nseidle/WOW-Scanner/README.md

Grocery Scanner
=======

Grocery scanner is an interactive exhibit at the [WOW kid's museum](http://www.wowchildrensmuseum.org/) in Lafayette, CO. Sliding a plastic fruit, empty box, or even your hand causes the scanner to turn on a bright red LED and beep with that satisfying grocery store checkout beep.

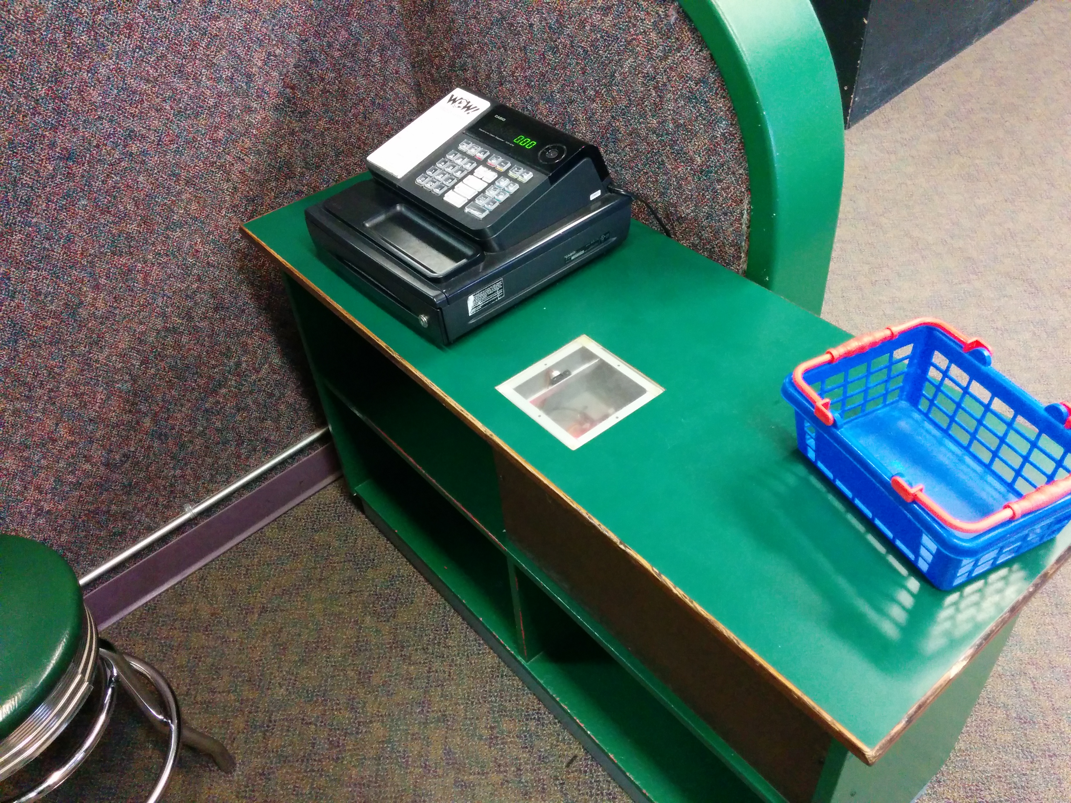
[picture p1: images/Scanner-Low-Height-Checkout.jpg]
The scanner installed in low height checkout counter


This exhibit was created by Chris Francis and has been maintained by Nathan Seidle. It is a tremendously popular exhibit. Kids really enjoy being able to do what their parents do at the store.

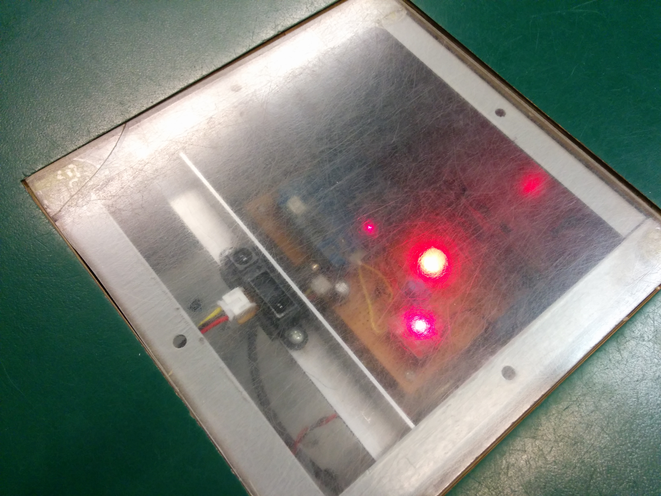
[picture p2: images/Scanner.jpg]
Scanner installed
  

The scanner is flush mounted to a low height checkout counter for small kids. The electronics are placed in a metal box with a clear acrylic cover. The cover in this picture has had 4 years of significant wear and tear but the IR distance sensor continues to function without problems.

This exhibit is rock solid and had been running for multiple years without maintenance.

License Information
-------------------

The hardware design and firmware are released under [Creative Commons Share-alike 3.0](http://creativecommons.org/licenses/by-sa/3.0/).  

Feel free to create your own copy of the Grocery Scanner. All I ask is that you include attribution of 'Based on the Grocery Scanner by Chris Francis'.

Repository Contents
-------------------
* **/hardware** - Unproven Eagle PCB layouts for an Arduino shield 
* **/firmware** - The sketch that runs on the Arduino Pro 
* **/images** - Images and a video of the scanner in use
