nseidle/WOW-Scanner/hardware/remote board.brd

## EAGLE design hardware/remote board.brd (2013-04-22)

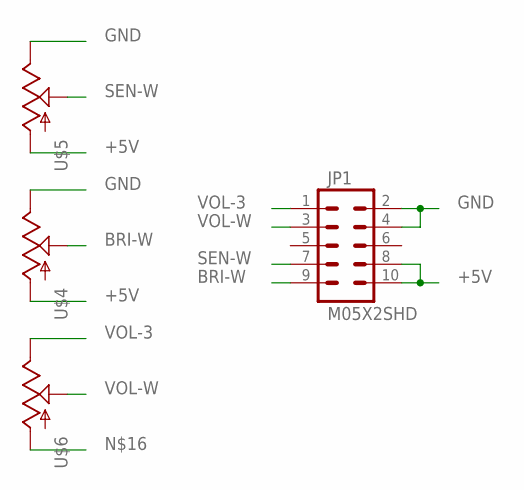
[picture p3: schematic remote board.sch]

Parts:
JP1: M05X2SHD; 2X5-SHROUDED
U$4, U$5, U$6: POT100K_3362U; 3362U

Connections:
+5V: JP1.8, JP1.10, U$4.P$3 (A), U$5.P$3 (A)
BRI-W: JP1.9, U$4.P$2 (S)
GND: JP1.2, JP1.4, U$4.P$1 (E), U$5.P$1 (E)
SEN-W: JP1.7, U$5.P$2 (S)
VOL-3: JP1.1, U$6.P$1 (E)
VOL-W: JP1.3, U$6.P$2 (S)

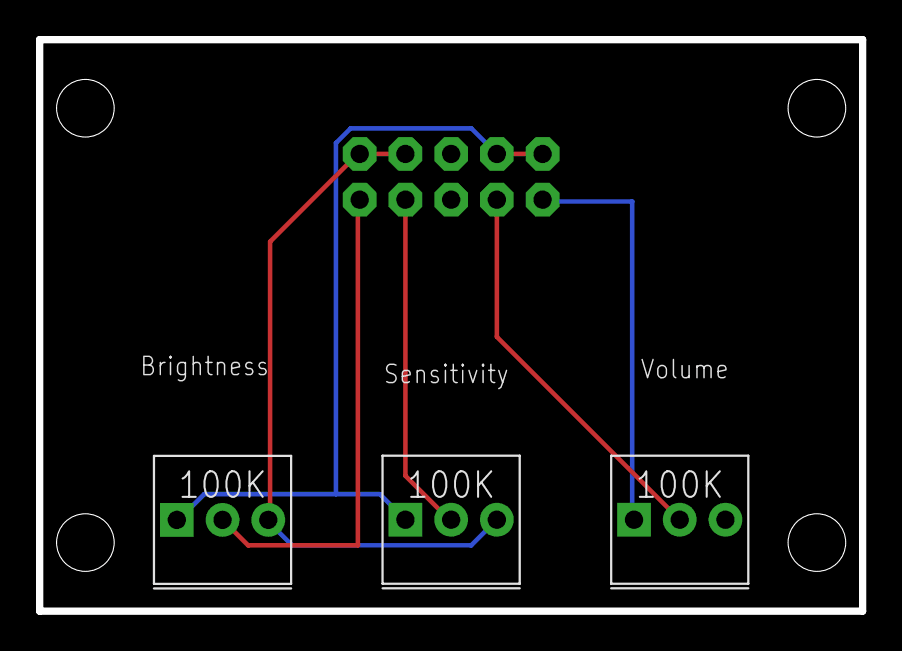
[picture p4: board remote board.brd from above]

Board: 2 copper layers, 45.7 x 31.8 mm, 4 parts (1 on the bottom side), 6 nets.
