nseidle/WOW-Scanner/hardware/WOW Scanner.brd

## EAGLE design hardware/WOW Scanner.brd (2013-04-22)

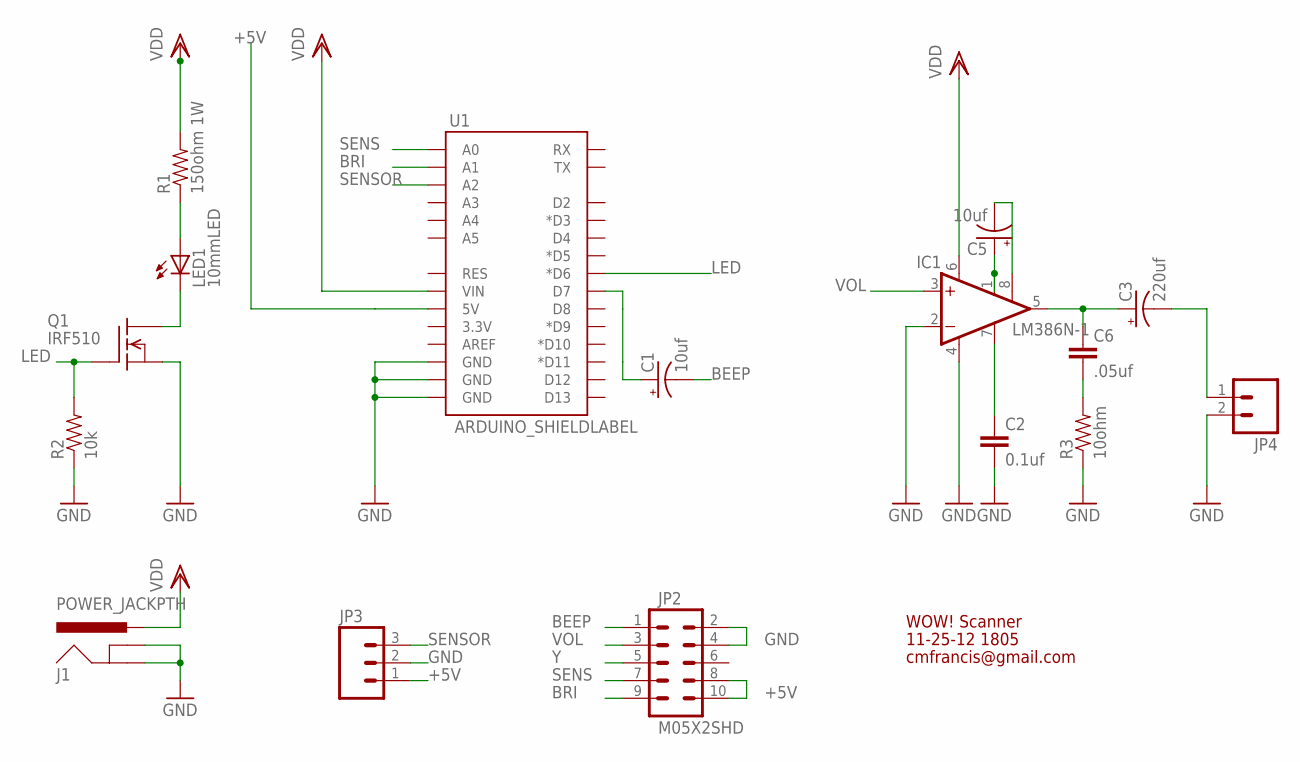
[picture p5: schematic WOW Scanner.sch]

Parts:
C1, C5: 10uf; CPOL-RADIAL-10UF-25V
C2: 0.1uf; CAP-PTH-SMALL
C3: 220uf; CPOL-RADIAL-100UF-25V
C6: .05uf; CAP-PTH-SMALL
IC1: LM386N-1; DIL08
J1: POWER_JACKPTH; POWER_JACK_PTH
JP2: M05X2SHD; 2X5-SHROUDED
JP3: M03JST-PTH; JST-3-PTH
JP4: M02PTH; 1X02
LED1: 10mmLED; LED10MM
Q1: IRF510; TO220
R1: 150ohm 1W; AXIAL-0.6
R2: 10k; AXIAL-0.4
R3: 10ohm; AXIAL-0.4
U1: ARDUINO_SHIELDLABEL; DUEMILANOVE_SHIELD

Connections:
+5V: JP2.8, JP2.10, JP3.1, U1.5V
BEEP: C1.2 (-), JP2.1
BRI: JP2.9, U1.A1
GND: C2.2, IC1.2 (-IN), IC1.4 (GND), J1.GND, J1.GNDBREAK, JP2.2, JP2.4, JP3.2, JP4.2, Q1.3 (S), R2.P$1 (1), R3.P$1 (1), U1.GND@0 (GND), U1.GND@1 (GND), U1.GND@2 (GND)
LED: Q1.1 (G), R2.P$2 (2), U1.D6 (*D6)
unnamed: LED1.A, R1.P$1 (1)
unnamed: LED1.C, Q1.2 (D)
unnamed: C2.1, IC1.7 (BYPASS)
unnamed: C6.2, R3.P$2 (2)
unnamed: C3.1 (+), C6.1, IC1.5 (OUT)
unnamed: C5.1 (+), IC1.1 (GAIN)
unnamed: C5.2 (-), IC1.8 (GAIN)
unnamed: C3.2 (-), JP4.1
unnamed: C1.1 (+), U1.D7
SENS: JP2.7, U1.A0
SENSOR: JP3.3, U1.A2
VDD: IC1.6 (VS), J1.PWR, R1.P$2 (2), U1.VIN
VOL: IC1.3 (+IN), JP2.3
Y: JP2.5

Notes on the sheet:
WOW! Scanner
11-25-12 1805
cmfrancis@gmail.com

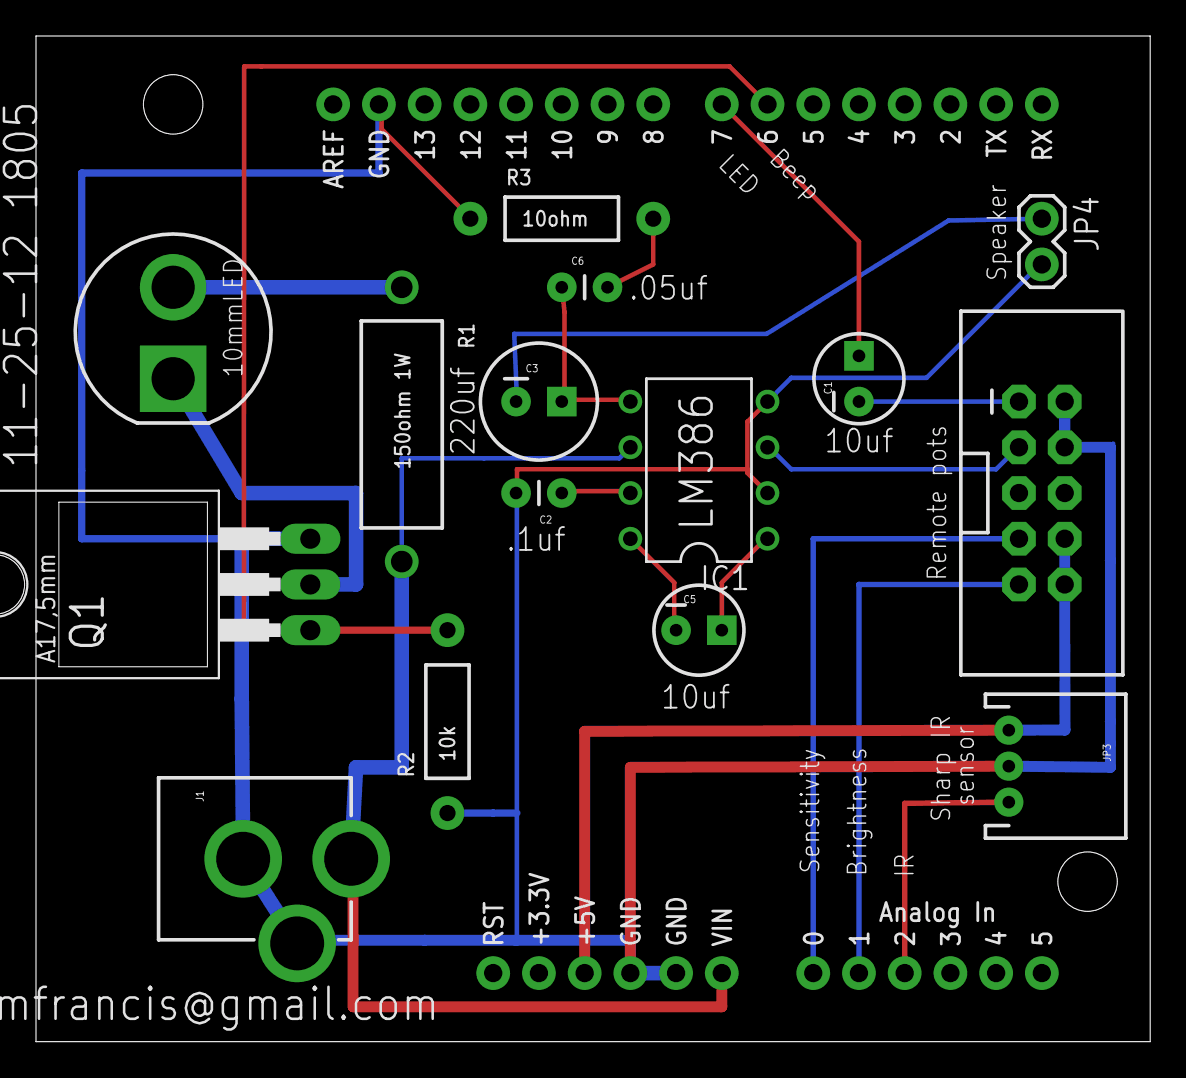
[picture p6: board WOW Scanner.brd from above]

Board: 2 copper layers, 61.9 x 55.9 mm, 16 parts (0 on the bottom side), 18 nets.
