nseidle/WOW-Scanner/(commit log)

2013-04-22 Upgraded sketch to INO file. Updated directory structure.
    No code changes. Added a small todo (add a watch dog and reset someday).
    [WOW Scanner.brd, WOW Scanner.sch, remote board.brd, remote board.sch]
2013-04-22 Added a function to average sensor readings.
2013-04-29 Removed trimpot checking.
    The hardware trimpots where not working (defective cable) so they were
    removed and replaced with a volume knob directly on the amp and a hard
    coded threshold value.
    [WOW_Scanner.ino]
